UBC-GSRC/2026-w2-kuhn-fluxchamber/notes/inspiration.md

# Inspiration Procedure: 

- The Inspiration page is to house any materials that provide a good example of relevant implementations. This can be hyperlinks to articles, photos, etc. Almost like a Pinterest board.  

- Always use the date for each entry and tag your initials (YYYY-MM-DD AF)  

- Always put a new entry at the top of the page so you can see the newest work first  

- Do not use this as a default daily log. This page should describe updates at a higher level than the log.  

- Do not delete entries, this is meant to serve as a rudimentary version control and archive.  

- Leave the Procedure at the top of the page.
  
For Links 
[Duck Duck Go](https://duckduckgo.com)

For photos

 

or  



[image-ref]: https://www.markdownlang.com/image.jpg "Optional Title"        

or

Local Image
Parent Directory Image
Same Directory Image
Root Directory Image

# 2025-11-27 DF
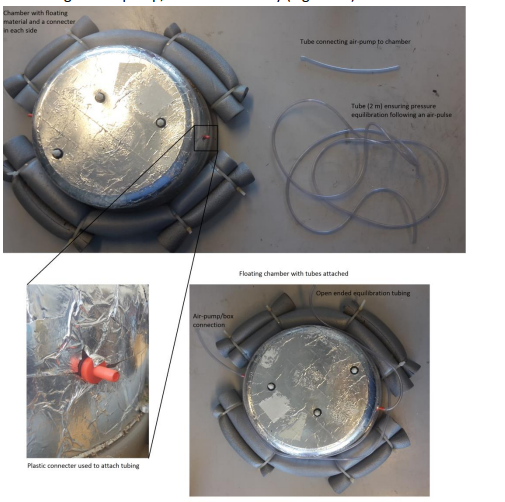
[picture p1: notes/images/co2_martinsen.png]
martinsen_co2flux

[martinsen_co2flux_suppliment](https://bg.copernicus.org/articles/15/5565/2018/bg-15-5565-2018-supplement.pdf)

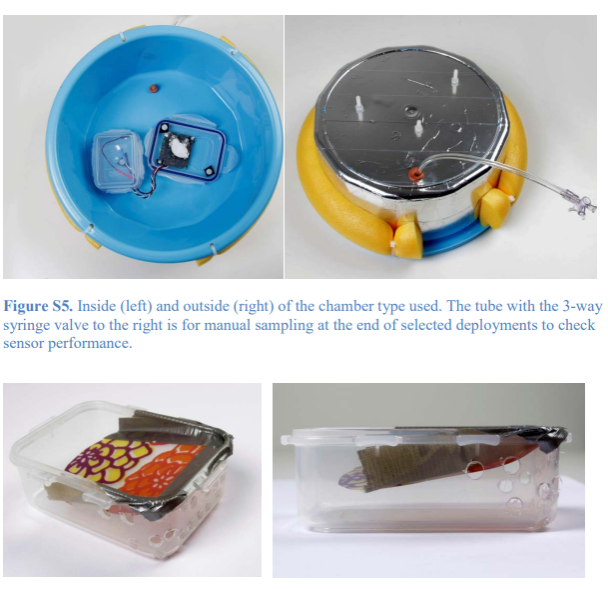
[picture p2: notes/images/bastvikken_co2flux.png]
bastvikken_co2flux

[bastvikken_co2flux_suppliment](https://bg.copernicus.org/articles/12/3849/2015/)

[woodwell_co2flux_context](https://www.woodwellclimate.org/zoe-dietrich-engineering-floating-methane-chamber/)
[woodwell_co2flux_suppliment](https://agupubs.onlinelibrary.wiley.com/action/downloadSupplement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)
