UBC-GSRC/2026-w2-kuhn-fluxchamber/firmware/supplemental/data_logger_uml_state_machine.drawio.png

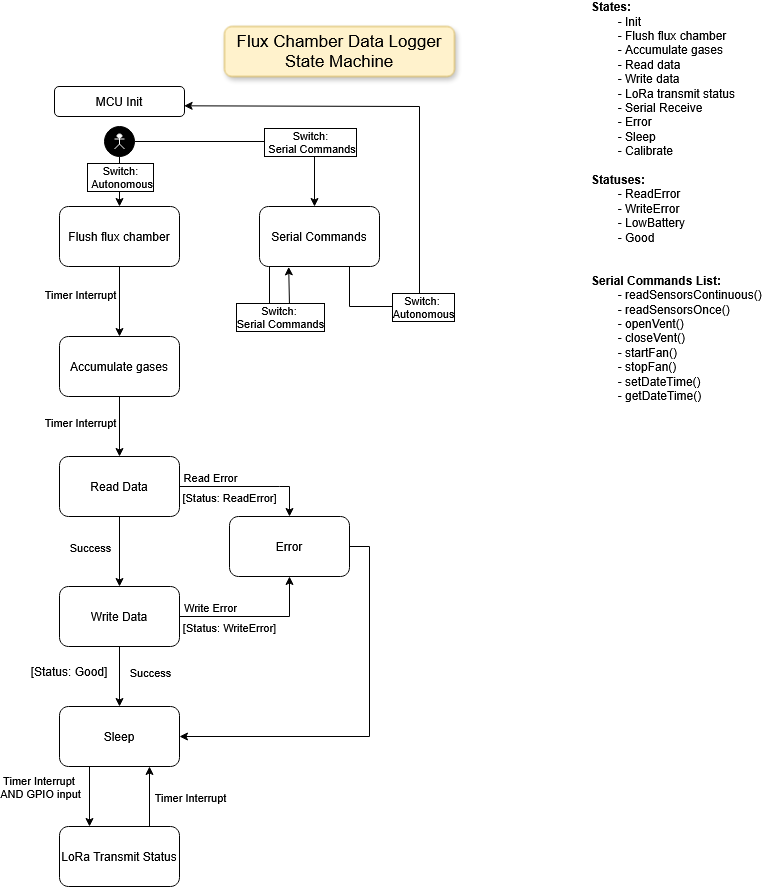
firmware/supplemental/data_logger_uml_state_machine.drawio.png
