UBC-GSRC/2026-w2-kuhn-fluxchamber/notes/key_components.md

# Key Components Procedure:  

- The Key Components page is to serve as a place to describe the details of key components. Think accuracy of sensors, load capacity of corner brackets, speed of motors, etc. If there is a 

- Always use the date for each entry and tag your initials (YYYY-MM-DD AF)  

- Always put a new entry at the top of the page so you can see the newest work first  

- Do not use this as a default daily log. This page should describe updates at a higher level than the log.  

- Do not delete entries, this is meant to serve as a rudimentary version control and archive.  

- Leave the Procedure at the top of the page.  

# 2025-11-27 

1ppm = 0.0001%
1% = 10000 ppm

| co2 | Measument Range | Accuracy | Repeatability | Datasheet |
| --- | --- | --- | --- | --- |
| SenseAir K33 ELG | 400ppm-5000ppm  | +/- 30ppm +/- 3% of measured value  | +/- 20ppm +/- 1% of measured value | (https://rmtplusstoragesenseair.blob.core.windows.net/docs/publicerat/PSP145.pdf)|
| Devin Fennerty | Devin.fennerty@ubc.ca  | Engineer | Name | Email |
| Adam Fong | Adam.fong@ubc.ca | Engineer | Name | Email |
| Name | Email | Role | Name | Email |
