UBC-GSRC/2026-w2-kuhn-fluxchamber/bill_of_materials/Bill Of Materials(Bill of Materials).csv

Bill of Materials
 |  |  |  |  |  | Total Pieces: | 53
 |  |  |  |  |  | Total Cost: | 1746.79
Final Part | Category | Name | Link | Quantity | Unit of Measurement | Per Unit Cost CAD | Shipping | True Cost | Has It been Ordered | How many ordered
Platform | Raw Materials | 24"x24"1/4" HDPE | https://www.grainger.ca/en/product/p/WWG1ZAY8?cm_mmc=PPC:+Google+PLA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 | 1 | Piece | $28.94 | $- | $28.94 | No
Platform | Raw Materials | 2" PVC Pipe | https://www.homedepot.ca/product/ipex-series-200-2-inch-x-10-feet-pvc-pipe-ips/1000667857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 | 3 | Piece 10 ft | $24.98 | $- | $74.94 | No
Platform | Raw Materials | 2" PVC T | https://www.grainger.ca/en/product/p/WWG22FL05?cm_mmc=PPC:+Google+PLA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 | 8 | Piece | $3.20 | $- | $25.60 | No
Platform | Raw Materials | 2" PVC Elbow | https://www.grainger.ca/en/product/p/WWG22FJ95?cm_mmc=PPC:+Google+PLA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 | 8 | Piece | $2.64 | $- | $21.12 | No
Platform | Raw Materials | Misc Bolts/Hardware | https://canadabolts.ca/products/metric-machine-screws-socket-head-cap-full-thread-stainless-steel-m6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 | 1 | Piece | $50.00 | $- | $50.00 | No
Electrical Box | Raw Materials | Din Rail | https://www.grainger.ca/en/product/p/GGE18Z760?cm_mmc=PPC:+Google+PLA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 | 1 | Piece | $6.85 | $- | $6.85 | Yes
Electrical Box | Raw Materials | Meija 24"x17"x12" case | https://www.amazon.ca/MEIJIA-Portable-Waterproof-Protection-Inserted/dp/B07ZBQTBRP?gad_source=1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 | 1 | Piece | $142.49 | $- | $142.49 | No
Electrical Box | Electrical Components | Battery 12V 50AH | https://www.amazon.ca/HumsiENK-Protection-Rechargeable-6000-15000-Lifetime/dp/B0FG7WVW8F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 | 1 | Piece | $149.99 | $- | $149.99 | No
Flux Chamber | Mechanical Components | Air Pump BD-02A-3L | https://bodenpumpstore.com/products/12v-eccentric-diaphragm-air-pump-bodenflo?variant=45735526138048 | 2 | Piece | $22.56 | $53.58 | $98.70 | Yes | 3 of them
Flux Chamber | Raw Materials | 10 Quart Bucket | https://www.uline.ca/BL_7028/Utility-Buckets?keywords=buckets | 1 | Piece | $19.00 | $- | $19.00 | No
Sensors | Raw Materials | 20"x20"x1" 20 PPI Foam | https://www.amazon.ca/ALEGI-Aquarium-Sponge-Filter-Sponges/dp/B0C99S8J7D?gad_source=1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 | 1 | Piece | $15.99 | $- | $15.99 | No
Sensors | Electrical Components | Figaro NGM 2611-E13 | https://www.figarosensor.com/product/entry/ngm2611.html | 7 | Piece | $33.74 | $60.00 | $296.18 | Yes
Sensors | Electrical Components | SenseAir K33 ELG | https://www.co2meter.com/en-ca/products/k-33-icb-co2-sensor?variant=19003982 | 1 | Piece | $400.00 | $- | $400.00 | No
Sensors | Electrical Components | SHT45 | https://www.mouser.ca/ProductDetail/Adafruit/5665?qs=mELouGlnn3dyBBHYyvKU4A%3D%3D | 1 | Piece | $20.00 |  | $20.00
Sensors | Raw Materials | 3D Filament PETG | https://3dprintingcanada.com/products/black-bambu-lab-petg-hf-filament-1-75mm-1-kg?variant=42508806684741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 | 1 | Spool | $29.99 | $- | $29.99
Data Logger | Electrical Components | QWIIC Breakout | https://www.mouser.ca/ProductDetail/485-5961 | 1 | Piece | $2.97 | $- | $2.97
Data Logger | Electrical Components | QWIIC Wire | https://www.mouser.ca/ProductDetail/485-4210 | 1 | Piece | $1.45 | $- | $1.45
Data Logger | Electrical Components | INA333 Amp | https://leeselectronic.com/en/product/18487-ina333-amplifier-op-amp-module-bio-micro-signal.html | 1 | Piece | $11.95 | $- | $11.95
Data Logger | Electrical Components | AD623 Amp | https://www.mouser.ca/ProductDetail/584-AD623ANZ | 1 | Piece | $14.84 | $- | $14.84
Data Logger | Electrical Components | RTC DS3231 Breakout Board | https://www.mouser.ca/ProductDetail/485-3013 | 1 | Piece | $26.64 | $- | $26.64
Data Logger | Electrical Components | External ADC I2C | https://www.mouser.ca/ProductDetail/Adafruit/5974?qs=IKkN%2F947nfAOkaWgHqoH5Q%3D%3D | 1 | Piece | $15.15 | $- | $15.15
Data Logger | Electrical Components | MISC Hardware | https://canadabolts.ca/products/metric-machine-screws-socket-head-cap-full-thread-stainless-steel-m2-5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 | 1 | Piece | $100.00 | $- | $100.00
Data Logger | Electrical Components | Solar Panel and charge controller | Eco-Worthy 25W 12V solar panel and controller ($60) | 1 | Piece | $60.00 | $- | $60.00
Data Logger | Electrical Components | Arduino MKR WAN | https://www.mouser.ca/ProductDetail/Arduino/ABX00029?qs=rkhjVJ6%2F3EJR8pfu7j970Q%3D%3D | 1 | Piece | $75.00 |  | $75.00
Data Logger | Electrical Components | DS3231 Breakout Board RTC | https://www.mouser.ca/ProductDetail/Adafruit/5188?qs=TCDPyi3sCW0TSTr1Xi7pUg%3D%3D | 1 | Piece | $22.00 |  | $22.00
Data Logger | Electrical Components | SanDisk Ultra 16GB | https://www.amazon.ca/SanDisk-Ultra-SDSQUNS-016G-GN3MN-UHS-I-microSDHC/dp/B074B4P7KD?s=electronics | 1 | Piece | $15.00 |  | $15.00
Data Logger | Electrical Components | L4931 5V Voltage Regulator | L4931 5V | 1 | Piece | $1.00 |  | $1.00
Data Logger | Electrical Components | L4931 3.3V Voltage Regulator | L4931 3.3V | 1 | Piece | $1.00 |  | $1.00
Data Logger | Electrical Components | MP1584 Buck Converter Breakout | MP1584 Buck Converter Breakout | 1 | Piece | $7.00 |  | $7.00
Data Logger | Electrical Components | 25W DC-DC Power Module | 25W DC-DC power module | 1 | Piece | $13.00 |  | $13.00
