UBC-GSRC/2026-w2-kuhn-fluxchamber/firmware/analysis/air_pump_rate_test_1.txt

This data came from a test in which two 12V air pumps were connected to the air chamber.
The air chamber did NOT have a water seal at the base so some CO2 was likely leaking from the poor
seal. But all of the wires at the top of the chamber were sealed using cable glands.

I took the first measurement, then exhaled into the chamber about 10 times. This saturated the sensor
to read 10,000 ppm. The rest is shown below.

NOTES:
- 2 air pumps, one pumping out one pumping in, simultaneously
- NO fan to circulate air

Date: 2025/12/22 Time: 13:42:50 CO2 (ppm): 581.0 Temp (C): 22.6 RH (%): 39.9
Date: 2025/12/22 Time: 13:43:21 CO2 (ppm): 835.0 Temp (C): 22.6 RH (%): 39.7
Date: 2025/12/22 Time: 13:43:52 CO2 (ppm): 10000.0 Temp (C): 23.1 RH (%): 99.9
Date: 2025/12/22 Time: 13:44:23 CO2 (ppm): 10000.0 Temp (C): 23.5 RH (%): 100.0
Date: 2025/12/22 Time: 13:44:54 CO2 (ppm): 10000.0 Temp (C): 23.2 RH (%): 100.0
Date: 2025/12/22 Time: 13:45:25 CO2 (ppm): 10000.0 Temp (C): 23.1 RH (%): 91.6
Date: 2025/12/22 Time: 13:45:56 CO2 (ppm): 10000.0 Temp (C): 23.1 RH (%): 88.5
Date: 2025/12/22 Time: 13:46:28 CO2 (ppm): 10000.0 Temp (C): 23.1 RH (%): 87.1
Date: 2025/12/22 Time: 13:46:59 CO2 (ppm): 9678.0 Temp (C): 23.0 RH (%): 86.3
Date: 2025/12/22 Time: 13:47:30 CO2 (ppm): 8155.0 Temp (C): 23.0 RH (%): 84.2
Date: 2025/12/22 Time: 13:48:01 CO2 (ppm): 6918.0 Temp (C): 22.9 RH (%): 82.7
Date: 2025/12/22 Time: 13:48:32 CO2 (ppm): 5880.0 Temp (C): 22.9 RH (%): 80.6
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
Date: 2025/12/22 Time: 14:04:37 CO2 (ppm): 515.0 Temp (C): 22.1 RH (%): 39.6
Date: 2025/12/22 Time: 14:05:09 CO2 (ppm): 516.0 Temp (C): 22.1 RH (%): 39.5
Date: 2025/12/22 Time: 14:05:40 CO2 (ppm): 511.0 Temp (C): 22.1 RH (%): 39.5
