UBC-GSRC/2026-w2-kuhn-fluxchamber/flux_measurements/flux_results.csv

start | end | n | dCdt_ppm_h | r2 | T_K | flux_umol_m2_h
2000-01-01 00:02:10 | 2000-01-01 00:11:59 | 20 | 583.701188455008 | 0.5923466164472444 | 298.25 | 4217.036079231312
2000-01-01 00:25:55 | 2000-01-01 00:35:44 | 20 | -59.54887218045173 | 0.3189687096252124 | 298.435 | -429.952993376065
2026-07-16 16:58:23 | 2026-07-16 17:08:12 | 20 | 101.3727868057231 | 0.9264781388520207 | 299.47499999999997 | 729.3869748710836
2026-07-16 18:58:26 | 2026-07-16 19:08:15 | 20 | 44.006791171475946 | 0.45430417146577173 | 299.64 | 316.45874793350947
2026-07-16 20:58:29 | 2026-07-16 21:08:18 | 20 | 48.02328401649263 | 0.8499387482158284 | 299.16499999999996 | 345.89020509823337
2026-07-16 22:58:32 | 2026-07-16 23:08:21 | 20 | 43.395585738538514 | 0.591656746198091 | 299.13 | 312.59553842191104
2026-07-17 00:58:34 | 2026-07-17 01:08:23 | 20 | 41.91122968712065 | 0.580539821403375 | 299.135 | 301.898089430233
2026-07-17 02:58:37 | 2026-07-17 03:08:26 | 20 | 38.59325733689059 | 0.5932561614051286 | 299.09 | 278.0396505644717
2026-07-17 04:58:40 | 2026-07-17 05:08:29 | 20 | 36.0611205432938 | 0.6377293307859382 | 298.955 | 259.9145474614893
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
