UBC-GSRC/2026-w2-kuhn-fluxchamber/power_measurements/complete_cycle_and_efficiency_dreams.csv

timestamp_local | current_mA | bus_V | shunt_mV | power_mW | energy_J | charge_C | temperature_C
2026-04-30T14:15:36 | -0.04 | 0 | 0 | 0 | 0 | 0 | 21.55
2026-04-30T14:15:37 | -0.02 | 0 | 0 | 0 | 0 | 0 | 21.54
2026-04-30T14:15:38 | -0.06 | 0 | 0 | 0 | 0 | 0 | 21.54
2026-04-30T14:15:39 | -0.13 | 0 | 0 | 0 | 0 | 0 | 21.54
2026-04-30T14:15:40 | -0.13 | 0 | 0 | 0 | 0 | 0 | 21.54
2026-04-30T14:15:41 | -0.04 | 0 | 0 | 0 | 0 | 0 | 21.53
2026-04-30T14:15:42 | -0.11 | 0 | 0 | 0 | 0 | 0 | 21.54
2026-04-30T14:15:43 | 0.06 | 0 | 0 | 0 | 0 | 0 | 21.55
2026-04-30T14:15:44 | -0.23 | 0 | 0 | 0 | 0 | 0 | 21.55
2026-04-30T14:15:45 | -0.02 | 0 | 0 | 0 | 0 | 0 | 21.56
2026-04-30T14:15:46 | 0.02 | 0 | 0 | 0 | 0 | 0 | 21.57 |  |  | Buck Converter Powering |  |  |  |  | Linear Regulator Powering
2026-04-30T14:15:47 | -0.11 | 0 | 0 | 0 | 0 | 0 | 21.57
2026-04-30T14:15:48 | -0.08 | 0 | 0 | 0 | 0 | 0 | 21.57 |  |  |  | State | Time (s) | Current Avg (mA) | Average mW |  | State | Time (s) | Current Avg (mA) | Average mW
2026-04-30T14:15:49 | 92.37 | 12.2 | 1.39 | 1127.26 | 0.77 | 0.07 | 21.57 | 1 | 257.1894355 | Opening | 1 | 10 | 1144.928 | 11449.28 | Opening | 1 | 10 | 3434.784 | 34347.84
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
