UBC-GSRC/2026-w2-kuhn-fluxchamber/flux_measurements/data/datalog.csv

date | time | co2 | temp | rh | V_ch4 | type | V_batt
2000/01/01 | 00:01:37 | 606.0 | 23.8 | 65.7 | 0.336 | 0
2000/01/01 | 00:02:10 | 593.0 | 24.0 | 65.0 | 0.355 | 1
2000/01/01 | 00:02:41 | 562.0 | 24.2 | 64.2 | 0.369 | 1
2000/01/01 | 00:03:12 | 562.0 | 24.4 | 63.6 | 0.381 | 1
2000/01/01 | 00:03:43 | 571.0 | 24.5 | 63.0 | 0.388 | 1
2000/01/01 | 00:04:14 | 561.0 | 24.6 | 62.5 | 0.393 | 1
2000/01/01 | 00:04:45 | 569.0 | 24.8 | 62.1 | 0.395 | 1
2000/01/01 | 00:05:16 | 562.0 | 24.9 | 61.8 | 0.396 | 1
2000/01/01 | 00:05:47 | 581.0 | 25.0 | 61.4 | 0.397 | 1
2000/01/01 | 00:06:18 | 611.0 | 25.1 | 61.0 | 0.398 | 1
2000/01/01 | 00:06:49 | 647.0 | 25.2 | 60.7 | 0.399 | 1
2000/01/01 | 00:07:20 | 602.0 | 25.3 | 60.3 | 0.399 | 1
2000/01/01 | 00:07:51 | 587.0 | 25.3 | 60.1 | 0.399 | 1
2000/01/01 | 00:08:22 | 665.0 | 25.4 | 61.3 | 0.398 | 1
2000/01/01 | 00:08:53 | 610.0 | 25.4 | 59.8 | 0.396 | 1
2000/01/01 | 00:09:24 | 645.0 | 25.5 | 59.6 | 0.396 | 1
2000/01/01 | 00:09:55 | 612.0 | 25.6 | 59.4 | 0.395 | 1
2000/01/01 | 00:10:26 | 620.0 | 25.6 | 59.3 | 0.392 | 1
2000/01/01 | 00:10:57 | 605.0 | 25.7 | 59.1 | 0.394 | 1
2000/01/01 | 00:11:28 | 674.0 | 25.7 | 59.4 | 0.395 | 1
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
