UBC-GSRC/2026-w2-kuhn-fluxchamber/kicad/data_logger/data_logger.kicad_pcb

## KiCad design kicad/data_logger/data_logger.kicad_pcb (2026-04-23)

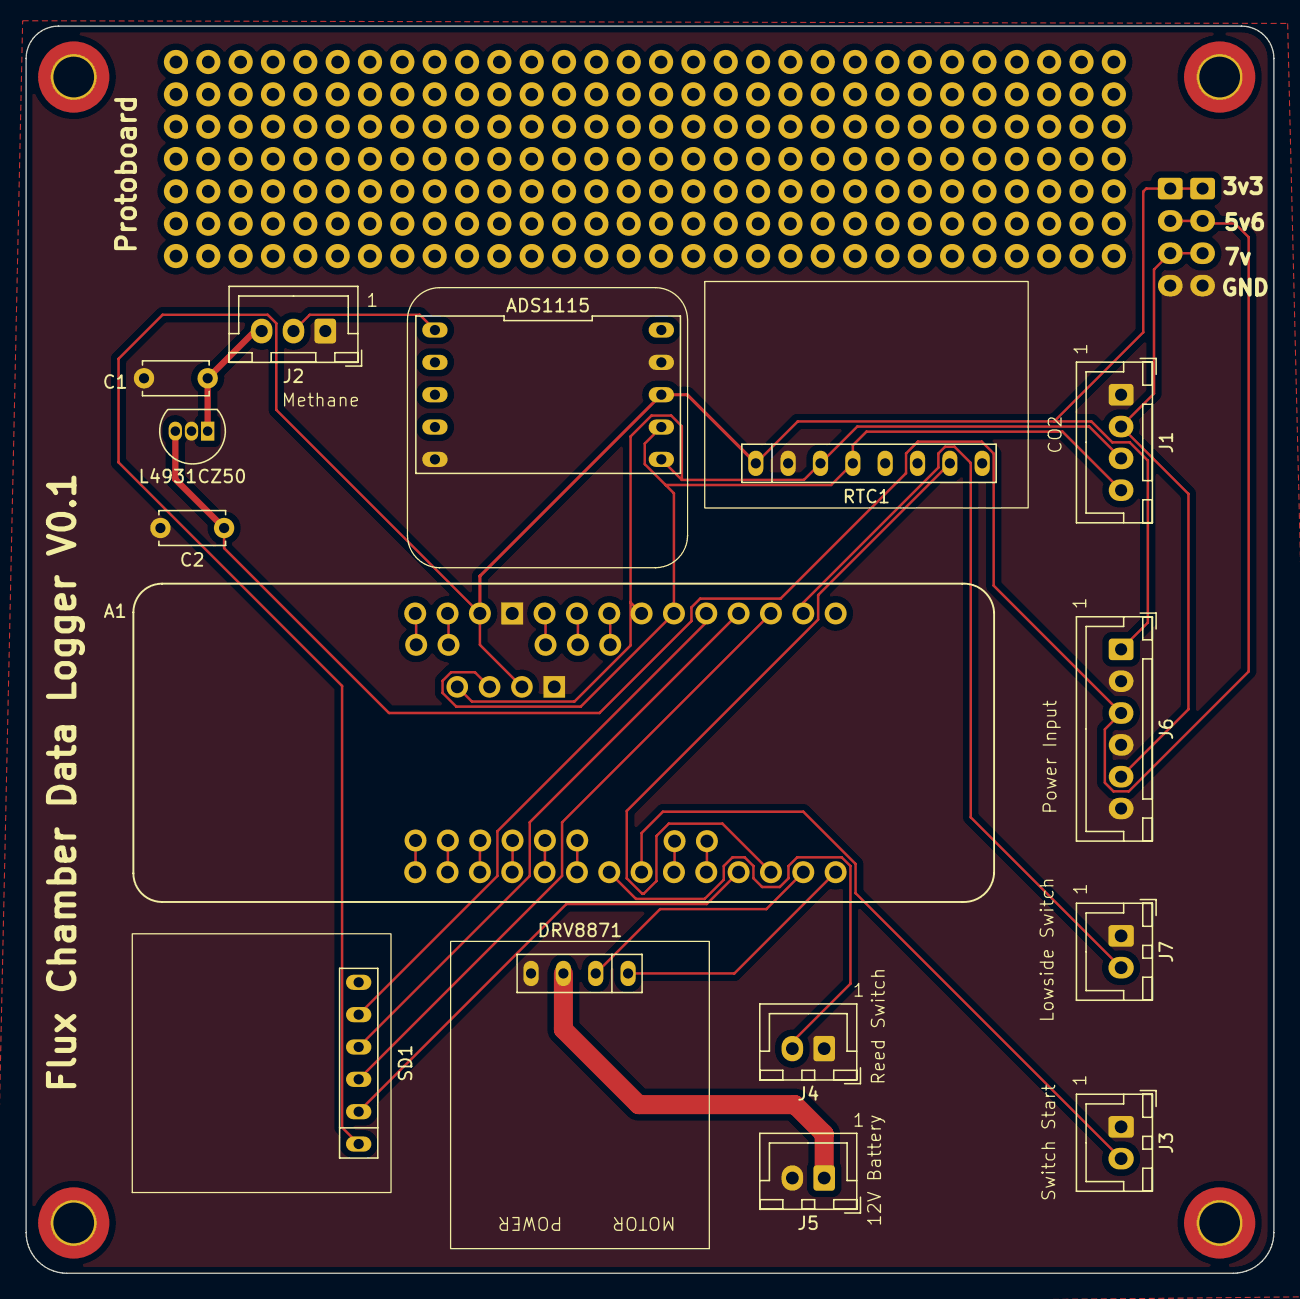
[picture p5: board data_logger.kicad_pcb from above]

Board: 2 copper layers, 98.0 x 98.0 mm, 15 parts (0 on the bottom side), 19 nets.

Parts:
A1: Arduino_MKR_WAN_1310_Socket; Arduino_MKR_FOX_1200_Socket
ADS1115: ADS1115_breakout_soldered
C1, C2: 2.2uF; C_Disc_D5.0mm_W2.5mm_P5.00mm
DRV8871: DRV8871
J1: Conn_01x04_Pin; JST_XH_B4B-XH-A_1x04_P2.50mm_Vertical
J2: Conn_01x03_Pin; JST_XH_B3B-XH-A_1x03_P2.50mm_Vertical
J3, J4, J5, J7: Conn_01x02_Pin; JST_XH_B2B-XH-A_1x02_P2.50mm_Vertical
J6: Conn_01x06_Pin; JST_XH_B6B-XH-A_1x06_P2.50mm_Vertical
L4931CZ50: TO-92L_Inline
RTC1: RTC_DS3231_breakout
SD1: SD Breakout Board; SD_Breakout_offbrand

Connections:
+5V: C1.1, J2.3, L4931CZ50.1 (V_OUT)
/3V3: A1.3V3 (3.3V), ADS1115.8 (VCC), J6.1, RTC1.1 (Vin), SD1.1 (3V3)
/5V6: C2.1, J6.3, L4931CZ50.3 (V_IN)
/6to9V: J1.2, J6.5
/D2: A1.D2, SD1.2 (CS)
/D3: A1.D3, RTC1.7 (SQW)
/D7: A1.D7, J7.2
/MISO: A1.D10 (D10_MISO), SD1.5 (MISO/POCI)
/MOSI: A1.D8 (D8_MOSI), SD1.3 (MOSI/PICO)
/PWM_forward: A1.D4, DRV8871.2 (IN1)
/PWM_reverse: A1.D5, DRV8871.1 (IN2)
/SCK: A1.D9 (D9_SCK), SD1.4 (CLK)
/SCL: A1.D12 (D12/SCL), ADS1115.6 (SCL), J1.3, RTC1.3 (SCL)
/SDA: A1.D11 (D11/SDA), ADS1115.7 (SDA), J1.4, RTC1.4 (SDA)
/SW_Start: A1.A6, J3.2
/SW_manual: A1.A5, J4.2
/V_bat: DRV8871.3 (VM), J5.1
/methane_out: ADS1115.1 (A0), J2.2
GND1: A1.GND, ADS1115.5 (GND), ADS1115.9 (GND), C1.2, C2.2, DRV8871.4 (GND), J1.1, J2.1, J3.1, J4.1, J5.2, J6.2, J6.4, J6.6, J7.1, L4931CZ50.2 (GND), RTC1.2 (GND)
