UBC-GSRC/2026-w2-kuhn-fluxchamber/kicad/logger_hat/logger_hat/logger_hat.kicad_pcb

## KiCad design kicad/logger_hat/logger_hat/logger_hat.kicad_pcb (2026-02-07)

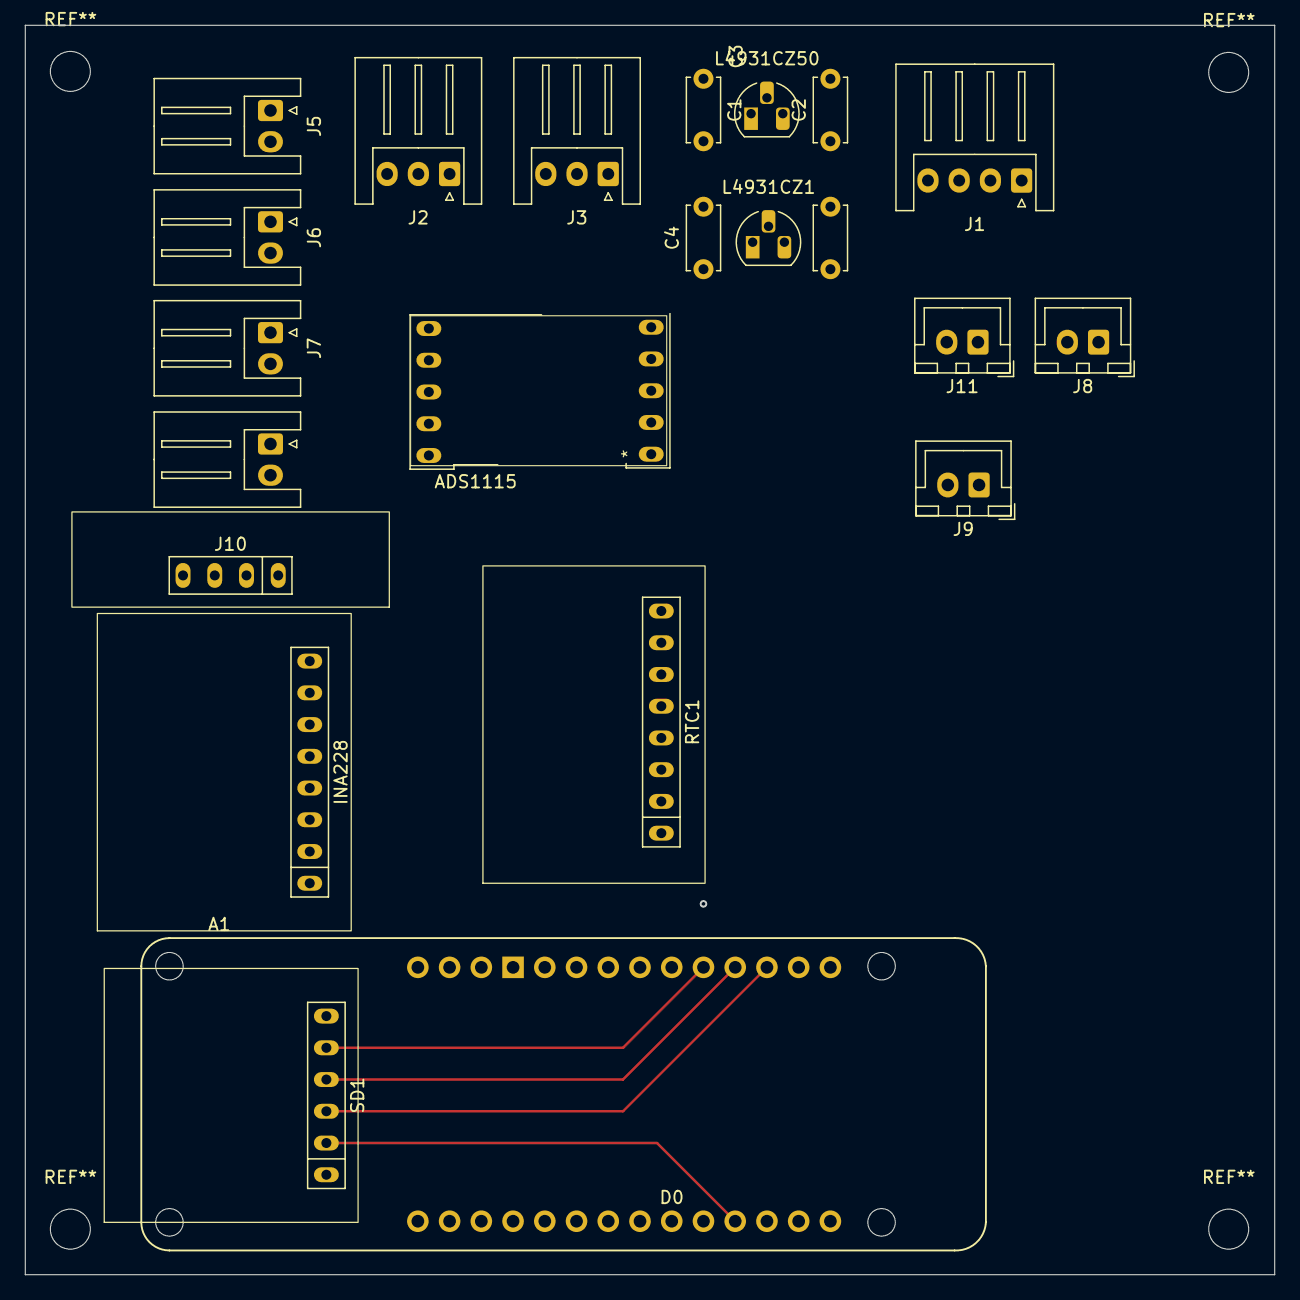
[picture p6: board logger_hat.kicad_pcb from above]

Board: 2 copper layers, 100.0 x 100.0 mm, 22 parts (0 on the bottom side), 20 nets.

Parts:
A1: Arduino_MKR_WAN_1310_Socket; Arduino_MKR_FOX_1200_Socket
ADS1115: ADC_16-bit_ADS1115_breakout
C1, C4: 2.2uF; C_Disc_D5.0mm_W2.5mm_P5.00mm
C2, C3: 0.1uF; C_Disc_D5.0mm_W2.5mm_P5.00mm
INA228: INA228_adafruit_module
J1: CO2_sensor_conn; JST_XH_S4B-XH-A_1x04_P2.50mm_Horizontal
J2: 3V3_sensor_conn; JST_XH_S3B-XH-A_1x03_P2.50mm_Horizontal
J3: CH4_Sensor_conn; JST_XH_S3B-XH-A_1x03_P2.50mm_Horizontal
J4: SW_RD; JST_XH_S2B-XH-A_1x02_P2.50mm_Horizontal
J5: PWM_output_1; JST_XH_S2B-XH-A_1x02_P2.50mm_Horizontal
J6: SW_LOG; JST_XH_S2B-XH-A_1x02_P2.50mm_Horizontal
J7: PWM_output_2; JST_XH_S2B-XH-A_1x02_P2.50mm_Horizontal
J8: 7V_IN; JST_XH_B2B-XH-A_1x02_P2.50mm_Vertical
J9: 3V3_IN; JST_XH_B2B-XH-A_1x02_P2.50mm_Vertical
J10: Conn_01x04_Pin; SparkFun_Stemma_Adapter
J11: 5V6_IN; JST_XH_B2B-XH-A_1x02_P2.50mm_Vertical
L4931CZ1, L4931CZ50: TO-92_HandSolder
RTC1: RTC_DS3231_breakout
SD1: SD Breakout Board; SD_Breakout_offbrand

Connections:
+3V3: C4.1, J2.1, L4931CZ1.1 (V_OUT)
+5V: C1.1, J3.1, L4931CZ50.1 (V_OUT)
/3V3: A1.3V3 (3.3V), ADS1115.8 (VCC), INA228.1 (VIN), J9.1, J10.2, RTC1.1 (Vin), SD1.1 (3V3)
/5V6: C2.1, C3.1, J11.1, L4931CZ1.3 (V_IN), L4931CZ50.3 (V_IN)
/6to9V: J1.2, J8.1
/D2: A1.D2, SD1.2 (CS)
/D3: A1.D3, RTC1.7 (SQW)
/D4: A1.D4, J6.1
/D5: A1.D5, J4.1
/D7: A1.D7, J7.1
/MISO: A1.D10 (D10_MISO), SD1.5 (MISO/POCI)
/MOSI: A1.D8 (D8_MOSI), SD1.3 (MOSI/PICO)
/PWM: A1.D1, J5.1
/SCK: A1.D9 (D9_SCK), SD1.4 (CLK)
/SCL: A1.D12 (D12/SCL), ADS1115.6 (SCL), INA228.3 (SCL), J1.4, J10.4, RTC1.3 (SCL)
/SDA: A1.D11 (D11/SDA), ADS1115.7 (SDA), INA228.4 (SDA), J1.3, J10.3, RTC1.4 (SDA)
/V_bat: INA228.5 (VBUS), INA228.7 (VIN+)
/methane_out: ADS1115.1 (A0), J3.2
/sensor_out: ADS1115.2 (A1), J2.2
GND: A1.GND, ADS1115.5 (GND), ADS1115.9 (GND), C1.2, C2.2, C3.2, C4.2, INA228.2 (GND), J1.1, J2.3, J3.3, J4.2, J5.2, J6.2, J7.2, J8.2, J9.2, J10.1, J11.2, L4931CZ1.2 (GND), L4931CZ50.2 (GND), RTC1.2 (GND), SD1.6 (GND)
