UBC-GSRC/2026-w2-kuhn-fluxchamber/firmware/src/main.cpp

#include <Arduino.h>
#include <SPI.h>
#include <SD.h>
#include "utils.h"
#include <Co2Meter_K33.h>
#include "ArduinoLowPower.h"
#include "SerialCommands.h"
#include <LoRa.h>
#include "INA226.h"

#define TYPE_CALIBRATION 0
#define TYPE_MEASUREMENT 1
#define TYPE_UNDER_VOLTAGE 2
#define MINIMUM_VOLTAGE 12.25

enum State {
  INIT,             // Initialize the system
  FLUSH_CHAMBER,    // Fill chamber with fresh air
  ACCUMULATE_AND_READ, // Accumulate gas and read data from sensors
  ACCUMULATE_GAS,   // Let gas accumulate in chamber before measurement
  READ_DATA,        // Read data from sensor(s)
  LOG_DATA,         // Log data to SD card
  SLEEP,            // Enter low-power sleep mode
  FAKE_SLEEP,       // Fake sleep for testing
  // LORA_RECEIVE,     // Listen for serial commands
  SLEEP_AND_TRANSMIT, // Sleep and transmit data over LoRa
  LORA_TRANSMIT,    // Transmit status over communication module
  SERIAL_COMMANDS,   // Listen for serial commands
  BLINK,            // Blink LED for testing
  CALIBRATE,        // Calibrate sensors
  TEST_BLINK_DELAY, // Test blinking with delay (blocking)
  TEST_BLINK_MILLIS, // Test blinking with millis (non-blocking)
  ERROR             // Handle errors
};

INA226 INA(0x40);
Co2Meter_K33 k33;
MethaneSensor methaneSensor(0);
State state = INIT;
// State state = FLUSH_CHAMBER;
// State state = SERIAL_COMMANDS;
State statePrev;

const char* datalogFile = "datalog.csv";
unsigned long stateStartMillis = 0;
unsigned long initStartUnixTime_s;
unsigned long accumulateStartUnixTime_s;
const unsigned long VENT_OPEN_DURATION = 5 * 1000; // Duration to open vent in milliseconds
const unsigned long VENT_CLOSE_DURATION = VENT_OPEN_DURATION + 1000; // Close for longer than open to ensure vent is fully closed
const unsigned long FAN_ON_DURATION = 30 * 1000;
const unsigned long CALIBRATE_DURATION = 60 * 1000; // milliseconds
const unsigned long FLUSH_DURATION = VENT_OPEN_DURATION + VENT_CLOSE_DURATION + FAN_ON_DURATION + CALIBRATE_DURATION; //  milliseconds
const unsigned long ACCUMULATE_DURATION = 3 * 1000; // milliseconds
const unsigned long MEASUREMENT_INTERVAL = 30 * 1000; // time between readings in milliseconds
const unsigned long MEASUREMENT_WINDOW = 10 * 60 * 1000; // time window in which we take periodic measurements in milliseconds 
const unsigned long MEASUREMENT_COUNT = (MEASUREMENT_WINDOW + 1000) / MEASUREMENT_INTERVAL; // number of measurements to take in the measurement window (adding a second to make sure integer division doesn't round down)
const unsigned long SAMPLE_INTERVAL = 1 * 60 * 60 * 1000; // milliseconds
const unsigned long CO2_GAS_DIFFUSION_DURATION = 25 * 1000; //  milliseconds
const unsigned long FAKE_SLEEP_DURATION = 15 * 1000; //  milliseconds for testing
const unsigned long LORA_TRANSMIT_INTERVAL = 10 * 60 * 1000; // milliseconds
const unsigned long SLEEP_AND_TRANSMIT_DURATION = SAMPLE_INTERVAL - FLUSH_DURATION - CO2_GAS_DIFFUSION_DURATION - MEASUREMENT_WINDOW; // milliseconds
const unsigned long LORA_TRANSMISSIONS_COUNT = SLEEP_AND_TRANSMIT_DURATION / LORA_TRANSMIT_INTERVAL; // number of lora transmissions during sleep and transmit state
const unsigned long LORA_TRANSMIT_DURATION = 300; // milliseconds
const unsigned long FINAL_SLEEP_DURATION = SLEEP_AND_TRANSMIT_DURATION - ((LORA_TRANSMISSIONS_COUNT * LORA_TRANSMIT_INTERVAL) + (LORA_TRANSMISSIONS_COUNT * LORA_TRANSMIT_DURATION)); // milliseconds
// const unsigned long SAMPLE_INTERVAL = 3 * 60 * 60 * 1000; // milliseconds (eventually should be between 1 and 3 hours, lowest you can reasonably do with your battery)
SensorData data;

unsigned PIN_WAKEUP = 3; // Pin to wake up from sleep
unsigned PIN_FAN = 7; // Pin to control fan
#define PIN_SWITCH A6 // Change to A6
#define PIN_REED_SWITCH A5 // Change to A5
unsigned PIN_MOTOR_FORWARD_PWM = 5;
unsigned PIN_MOTOR_REVERSE_PWM = 4;
unsigned localAddress = 0xBB; // LoRa local address
unsigned destinationAddress = 0xFF; // LoRa destination address
bool flagReadContinuous = false; // Flag to indicate continuous reading mode
bool flagTransmitLora = false;

void ledStateIndicator(int numBlinks) {
  for (int i = 0; i < numBlinks; i++) {
    digitalWrite(LED_BUILTIN, HIGH);
    delay(200);
    digitalWrite(LED_BUILTIN, LOW);
    delay(200);
  }
}

void LoRaTransmitSingle(bool calibration = false){
  if (!LoRa.begin(915E6)) {
      while (1){
        digitalWrite(LED_BUILTIN, HIGH);
        delay(100);
        digitalWrite(LED_BUILTIN, LOW);
        delay(100);
      }
    }

    char t[16];
    rtc_get_time(2, t, sizeof(t));
    LoRa.beginPacket();
    LoRa.write(destinationAddress);
    LoRa.write(localAddress);
    LoRa.print("Date: "); LoRa.print(data.date);
    LoRa.print(" Time: "); LoRa.print(data.time);
    LoRa.print(" Temp: "); LoRa.print(data.temp);
    LoRa.print(" RH: "); LoRa.print(data.rh);
    LoRa.print(" CO2: "); LoRa.print(data.co2);
    LoRa.print(" CH4: "); LoRa.print(data.ch4);
    LoRa.print(" V: "); LoRa.print(data.voltage);
    if (calibration){
      LoRa.print(" Type: Calibration");
    } else {
      LoRa.print(" Type: Measurement");
    }
    
    LoRa.endPacket();

    LoRa.end();
}
void wakeupCallback() {
  // This function will be called once on device wakeup
  state = LORA_TRANSMIT;
}

void rtcAlarmCallback(){
  flagTransmitLora = true;
}

void turnOnFan(int duration_ms) {
  digitalWrite(PIN_FAN, HIGH);
  delay(duration_ms);
  digitalWrite(PIN_FAN, LOW);
}

void reedSwitchCallback(){
  // Change this to start a full read sequence instead of just blinking
  state = BLINK;
}

void openVent(){
  digitalWrite(PIN_MOTOR_REVERSE_PWM, LOW); // Ensure reverse is off

  digitalWrite(PIN_MOTOR_FORWARD_PWM, HIGH); // Full speed forward
  delay(VENT_OPEN_DURATION); // Run motor for specified duration
  digitalWrite(PIN_MOTOR_FORWARD_PWM, LOW ); // Stop motor
}

void closeVent(){
  digitalWrite(PIN_MOTOR_FORWARD_PWM, LOW); // Ensure forward is off

  digitalWrite(PIN_MOTOR_REVERSE_PWM, HIGH); // Full speed reverse
  delay(VENT_CLOSE_DURATION); // Run motor for specified duration
  digitalWrite(PIN_MOTOR_REVERSE_PWM, LOW); // Stop motor
}

void readDataBlocking(bool calibration = false){
  k33.initPoll();
  delay(CO2_GAS_DIFFUSION_DURATION);

  // wait until CO2 sensor is ready, then read data        
  rtc_get_time(1, data.date, sizeof(data.date));
  rtc_get_time(2, data.time, sizeof(data.time));
  snprintf(data.temp, sizeof(data.temp), "%.1f", k33.readTemp());
  delay(20);
  snprintf(data.rh, sizeof(data.rh), "%.1f", k33.readRh());
  delay(20);
  snprintf(data.co2, sizeof(data.co2), "%.1f", k33.readCo2());
  delay(20);
  snprintf(data.ch4, sizeof(data.ch4), "%.3f", methaneSensor.readVoltage());
  delay(20);
  snprintf(data.voltage, sizeof(data.voltage), "%.3f", INA.getBusVoltage());
  delay(20);

  if (calibration){
    snprintf(data.type, sizeof(data.type), "%d", TYPE_CALIBRATION);
  } else {
    snprintf(data.type, sizeof(data.type), "%d", TYPE_MEASUREMENT);
  }
  
  if (Serial) {
    Serial.print("Date: "); Serial.print(data.date);
    Serial.print(" Time: "); Serial.print(data.time);
    Serial.print(" CO2 (ppm): "); Serial.print(data.co2);
    Serial.print(" Temp (C): "); Serial.print(data.temp);
    Serial.print(" RH (%): "); Serial.print(data.rh);
    Serial.print(" CH4 (V): "); Serial.println(data.ch4);
    Serial.print(" Type: "); Serial.println(data.type);
    Serial.print(" Voltage: "); Serial.println(data.voltage);
  }
}

void setup() {
    Serial.begin(9600);
    Serial.println("SD Initializing...");
    if (!SD.begin(chipSelectSD)) {
    }

    // Create file if missing
    if (!SD.exists(datalogFile)) {
        File file = SD.open(datalogFile, FILE_WRITE);
        if (file) {
            Serial.print("Created file: ");
            Serial.println(datalogFile);
            file.close();
        } else {
            Serial.print("Failed to create file: ");
            Serial.println(datalogFile);
        }
    }

    Serial.println("SD initialization done.");
    rtc_init(false); // false = do not set time
    Wire.begin();
    methaneSensor.begin();
    INA.begin();
    INA.setMaxCurrentShunt(1, 0.002);

    pinMode(PIN_WAKEUP, INPUT_PULLUP);
    pinMode(PIN_FAN, OUTPUT);
    pinMode(PIN_SWITCH, INPUT_PULLUP);
    pinMode(PIN_REED_SWITCH, INPUT_PULLUP);
    pinMode(PIN_MOTOR_FORWARD_PWM, OUTPUT);
    pinMode(PIN_MOTOR_REVERSE_PWM, OUTPUT);

    LowPower.attachInterruptWakeup(PIN_WAKEUP, wakeupCallback, CHANGE);
    LowPower.attachInterruptWakeup(PIN_REED_SWITCH, reedSwitchCallback, FALLING);
    // attachInterrupt(digitalPinToInterrupt(PIN_REED_SWITCH), reedSwitchCallback, FALLING);
}

void loop() {
  switch (state) {

    case INIT:{
      // Initialization 
      if (Serial){
          Serial.println("INIT");
        }
        
      if (digitalRead(PIN_SWITCH) == LOW){
        state = SERIAL_COMMANDS; // Go to serial commands if switch is low 
      } else {
        state = FLUSH_CHAMBER; // Start in normal mode if switch is high
      }
      break;
    }
    
    case FLUSH_CHAMBER:{
      // Flush the chamber to reach equilibrium with ambient air.
      // 1. Open vent 
      // 2. Turn on fan for set duration
      // 3. Close vent
      if (stateStartMillis == 0) {
        if (Serial){
          Serial.println("FLUSH_CHAMBER");
        }
        // Safety to prevent discharging past minimum safe voltage. Waits to get more charge from solar
        // Sleep for a long time!
        while (INA.isConnected() & INA.getBusVoltage() < MINIMUM_VOLTAGE){ 
          rtc_get_time(1, data.date, sizeof(data.date));
          rtc_get_time(2, data.time, sizeof(data.time));
          snprintf(data.temp, sizeof(data.temp), "%.1f", 0);
          delay(20);
          snprintf(data.rh, sizeof(data.rh), "%.1f", 0);
          delay(20);
          snprintf(data.co2, sizeof(data.co2), "%.1f", 0);
          delay(20);
          snprintf(data.ch4, sizeof(data.ch4), "%.3f", 0);
          delay(20);
          snprintf(data.type, sizeof(data.type), "%d", TYPE_UNDER_VOLTAGE);
          delay(20);
          snprintf(data.voltage, sizeof(data.voltage), "%.3f", INA.getBusVoltage());
          delay(20);
          
          log_data(data, datalogFile); 
          LowPower.sleep(1 * 60 * 60 * 1000);
        }

        stateStartMillis = millis();
        initStartUnixTime_s = rtc.now().unixtime();
        // open vent 
        openVent();
        digitalWrite(PIN_FAN, HIGH);
        delay(FAN_ON_DURATION);
        // Sleep a bit before starting sensor reading procedure
        digitalWrite(PIN_FAN, LOW);
        delay(CALIBRATE_DURATION - CO2_GAS_DIFFUSION_DURATION); // Wait for calibration duration
        readDataBlocking(true); // Read data after calibration duration
        log_data(data, datalogFile); // Log data after calibration duration
        LoRaTransmitSingle(true); // Transmit data after calibration duration
        closeVent();
        state = ACCUMULATE_AND_READ;
        stateStartMillis = 0;
      }
      break;
    }

    case ACCUMULATE_AND_READ: {
      // Let gas accumulate in chamber through diffusive flux and read data from sensors periodically
      unsigned long elapsedTime = rtc.now().unixtime() - accumulateStartUnixTime_s;
      if (stateStartMillis == 0) {
        if (Serial){
          Serial.println("ACCUMULATE_AND_READ");
        }
        stateStartMillis = millis();
      }
      // else if (elapsedTime >= (MEASUREMENT_WINDOW / 1000)) { // Accumulate and read for a set duration
      //   state = SLEEP_AND_TRANSMIT; // Move to SLEEP_AND_TRANSMIT state after the accumulation and reading duration
      //   stateStartMillis = 0;
      // }
      else if (MEASUREMENT_COUNT > 0) { // Read data at set intervals
        // send message to CO2 sensor to start reading data
        for (int i = 0; i < MEASUREMENT_COUNT; i++) {
          k33.initPoll();
          
          // Sleep for the duration of CO2 gas diffusion
          LowPower.sleep(CO2_GAS_DIFFUSION_DURATION); 
          
          // get data
          unsigned long procTime = millis();
          rtc_get_time(1, data.date, sizeof(data.date));
          rtc_get_time(2, data.time, sizeof(data.time));
          snprintf(data.temp, sizeof(data.temp), "%.1f", k33.readTemp());
          delay(20);
          snprintf(data.rh, sizeof(data.rh), "%.1f", k33.readRh());
          delay(20);
          snprintf(data.co2, sizeof(data.co2), "%.1f", k33.readCo2());
          delay(20);
          snprintf(data.ch4, sizeof(data.ch4), "%.3f", methaneSensor.readVoltage());
          delay(20);
          snprintf(data.type, sizeof(data.type), "%d", TYPE_MEASUREMENT);
          delay(20);
          snprintf(data.voltage, sizeof(data.voltage), "%.3f", INA.getBusVoltage());
          delay(20);
          
          // write to SD
          log_data(data, datalogFile); 
          
          // send LoRa transmission
          LoRaTransmitSingle(false);
          unsigned long totalProcTime = millis() - procTime;
          
          // sleep until the next measurement interval
          LowPower.sleep(MEASUREMENT_INTERVAL - CO2_GAS_DIFFUSION_DURATION - totalProcTime); // Sleep for the remaining time in the measurement interval. Subtract 300 ms to not overshoot
        }
        state = SLEEP_AND_TRANSMIT; // Move to SLEEP_AND_TRANSMIT state after the accumulation and reading duration
        stateStartMillis = 0;
      }
      break;
    }

    case ACCUMULATE_GAS:{
      // Let gas accumulate in chamber through diffusive flux 
      // 1. Wait for set duration (sleep?) 
      if (stateStartMillis == 0) {
        if (Serial){
          Serial.println("ACCUMULATE_GAS");
        }
        stateStartMillis = millis();
      }
      else if (millis() - stateStartMillis >= ACCUMULATE_DURATION) { // Accumulate for 10 seconds
        state = READ_DATA;
        stateStartMillis = 0;
      }
      break;
    }

    case READ_DATA: {
      // Read data from sensors 
      // 1. Read timestamp from RTC, temperature, humidity, CO2 and methane voltage from sensors
      if (stateStartMillis == 0) {
        if (Serial){
          Serial.println("READ_DATA");
        }
        stateStartMillis = millis();
        k33.initPoll();
      }
      else if (millis() - stateStartMillis >= CO2_GAS_DIFFUSION_DURATION) { // Warmup
        // wait until CO2 sensor is ready, then read data        
        // progress in the state machine
        rtc_get_time(1, data.date, sizeof(data.date));
        rtc_get_time(2, data.time, sizeof(data.time));
        snprintf(data.temp, sizeof(data.temp), "%.1f", k33.readTemp());
        delay(20);
        snprintf(data.rh, sizeof(data.rh), "%.1f", k33.readRh());
        delay(20);
        snprintf(data.co2, sizeof(data.co2), "%.1f", k33.readCo2());
        delay(20);
        snprintf(data.ch4, sizeof(data.ch4), "%.3f", methaneSensor.readVoltage());
        delay(20);
        snprintf(data.voltage, sizeof(data.voltage), "%.3f", INA.getBusVoltage());
        delay(20);
          
        stateStartMillis = 0;
        
        if (Serial) {
          Serial.print("Date: "); Serial.print(data.date);
          Serial.print(" Time: "); Serial.print(data.time);
          Serial.print(" CO2 (ppm): "); Serial.print(data.co2);
          Serial.print(" Temp (C): "); Serial.print(data.temp);
          Serial.print(" RH (%): "); Serial.print(data.rh);
          Serial.print(" CH4 (V): "); Serial.print(data.ch4);
        }
        state = LOG_DATA;
      }
      else {
        digitalWrite(LED_BUILTIN, HIGH); // Turn on LED while waiting for sensor to be ready
        delay(1000);
        digitalWrite(LED_BUILTIN, LOW); // Turn off LED after reading data
        delay(1000);
      }
      break;
    }

    case LOG_DATA: {
      // Log data to SD card
      if (Serial){
          Serial.println("LOG_DATA");
      }

      log_data(data, datalogFile); 
      state = LORA_TRANSMIT;
      break;
    }

    case SLEEP_AND_TRANSMIT:{
        if (LORA_TRANSMISSIONS_COUNT > 0) {
          for (unsigned long i = 0; i < LORA_TRANSMISSIONS_COUNT; i++) {
            LowPower.sleep(LORA_TRANSMIT_INTERVAL); // Sleep for the duration of the LORA transmit interval before transmitting
            LoRaTransmitSingle();
          }
        }
        LowPower.sleep(FINAL_SLEEP_DURATION); // Sleep for the final duration before restarting the cycle
        state = FLUSH_CHAMBER; // Restart the cycle
        break;
    }

    case LORA_TRANSMIT:{
      // Transmit information over LORA
      if (Serial){
        Serial.println("LORA_TRANSMIT");
      } 

      LoRaTransmitSingle();

      state = SLEEP;
      break;
    }

    // case LORA_RECEIVE:{
    //   // Listen for incoming LORA packets which match a known format
    //   // Listen for a set duration 
    //   if (Serial){
    //       Serial.println("LORA_RECEIVE");
    //   }
    //   state = SLEEP;

    //   break;
    // }

    case SLEEP:{
      // Enter low-power sleep mode 
      // 1. Set an alarm on the RTC to wake up after set duration
      // 2. Enter sleep mode 
      if (Serial){
          Serial.println("SLEEP");
      } 

      // rtc.setAlarm1(rtc.now() + TimeSpan(SLEEP_DURATION), DS3231_A1_Second); // Wake up after 60 seconds. May need to add back into code! Pretty sure this doesn't work tho.
      // rtc.now().unixtime() - initStartUnixTime_s < MEASUREMENT_WINDOW / 1000
      if (rtc.now().unixtime() - initStartUnixTime_s >= (SAMPLE_INTERVAL / 1000) - (LORA_TRANSMIT_INTERVAL / 1000)) { // Restart the sampling process after crossing the sample interval time threshold. Accounts for how long it takes to flush before getting your reading
        state = FLUSH_CHAMBER;
      }
      else {
        state = LORA_TRANSMIT; // Transmit again after waking up
        LowPower.sleep(LORA_TRANSMIT_INTERVAL); // Should this be deepSleep?
      }
      break;
    }

    case FAKE_SLEEP:{
      // Fake sleep for testing purposes
      if (stateStartMillis == 0) {
        stateStartMillis = millis();
        if (Serial){
          Serial.println("FAKE_SLEEP");
        } 
        // TODO: start flushing logic
      }
      else if (millis() - stateStartMillis >= FAKE_SLEEP_DURATION) { // Flush for 10 seconds
        state = ACCUMULATE_GAS;
        stateStartMillis = 0;
        state = INIT;
      }
      break;
    }

   

    case SERIAL_COMMANDS:{
      // Listen for serial commands. 
      // This is designed to be used with a list of commands to call important functions of the flux chamber for manual operation
      // Only necessary for easy testing, debugging, etc. Not needed for most people
      // Logic mostly written by Robin2 on https://forum.arduino.cc/t/simple-code-to-send-a-struct-between-arduinos-using-serial/672196 
      if (digitalRead(PIN_SWITCH) == HIGH) { // Wait for 5 seconds
        state = INIT; // return to normal operations 
        stateStartMillis = 0;
      }

      Serial.begin(9600);
      while(!Serial){
        // if (digitalRead(PIN_SWITCH) == HIGH) { 
        //   state = INIT; // return to normal operations 
        // }
        delay(100);
      }
      Serial.println("Ready for serial commands.");

      Command rxData;
      // while (digitalRead(PIN_SWITCH) == LOW){
      while (digitalRead(PIN_SWITCH) == LOW){
        if (recvStruct(&rxData)){
          // Process command based on rxData.id
          switch (rxData.id) {
            case 1:
              readDataBlocking();
              break;
            case 2:
              Serial.println("Received command to readSensorsOnce.");
              readDataBlocking();
              break;
            case 3:
              Serial.println("Received command to openVent.");
              openVent();
              break;
            case 4:
              Serial.println("Received command to closeVent.");
              closeVent();
              break;
            case 5:
              Serial.println("Received command to startFan.");
              digitalWrite(PIN_FAN, HIGH);
              break;
            case 6:
              Serial.println("Received command to stopFan.");
              digitalWrite(PIN_FAN, LOW);
              break;
            case 7:  
              Serial.println("Received command to setDateTime.");
              rtc.adjust(DateTime(rxData.year, rxData.month, rxData.day, rxData.hour, rxData.minute, rxData.second));
              Serial.println("DateTime SET:");
              Serial.print(rxData.year);
              Serial.print("-");
              Serial.print(rxData.month);
              Serial.print("-");
              Serial.println(rxData.day);
              Serial.print(rxData.hour);
              Serial.print(":");
              Serial.print(rxData.minute);  
              Serial.print(":");
              Serial.println(rxData.second);
              break;
            case 8:
              Serial.println("Received command to getDateTime.");
              char t[16];
              rtc_get_time(2, t, sizeof(t));
              Serial.print("Time:");
              Serial.println(t);
              break;
            case 9:
              Serial.println("Received command to transmitLoRa.");
              
              LoRaTransmitSingle();
            
              break;
            default:
              Serial.print("Unknown command ID: ");
              Serial.println(rxData.id);
              break;
          }
        }
        else if(flagReadContinuous && statePrev == READ_DATA) {
          state = READ_DATA;
          statePrev = SERIAL_COMMANDS;
        }
        else{
          delay(100);
        }
      }
      
      break;
    }
    case BLINK: {
      unsigned counter = 0;
      while (counter < 10){
        digitalWrite(LED_BUILTIN, HIGH);
        delay(500);
        digitalWrite(LED_BUILTIN, LOW);
        delay(100);
        counter++;
      }

      state = CALIBRATE; // Return to calibration mode after blinking
      break;
    }
    case CALIBRATE:{
      // Calibrate sensors. Print sensor readings to Serial for comparison with licor 
      if (!Serial){
          Serial.begin(9600);
          Serial.println("CALIBRATE");
      }

      if (digitalRead(PIN_SWITCH) == LOW){
        // state = CALIBRATE; // Stay in calibration mode
        delay(100);
        Serial.println("Switch is low");
        
        checkSerial();
        stateStartMillis = 0;
        statePrev = CALIBRATE;
        state = READ_DATA;
      } else {
        // state = INIT; // Move to logging mode
        delay(100);
        Serial.println("Switch is high");
        Serial.end();
        
        stateStartMillis = 0;
        state = INIT;
      }
      // delay(15000); //    Wait 15 seconds more, CO2 sensor already has 15 second delay
      // delay(5000); //    Wait 15 seconds more, CO2 sensor already has 15 second delay
      break;
    }
  case TEST_BLINK_DELAY: {
    Serial.println("TEST_BLINK_DELAY (blocking)");

    unsigned long start = millis();
    digitalWrite(LED_BUILTIN, HIGH);
    delay(5000); // Keep LED on for 5 seconds
    digitalWrite(LED_BUILTIN, LOW);

    Serial.println("TEST_BLINK_DELAY done");
    state = TEST_BLINK_DELAY;   // return where you want
    break;
    }
  
  case TEST_BLINK_MILLIS: {
    static bool initialized = false;
    static unsigned long start = 0;
    static unsigned long lastToggle = 0;
    static bool ledState = false;

    if (!initialized) {
        Serial.println("TEST_BLINK_MILLIS (non-blocking)");
        initialized = true;
        start = millis();
        lastToggle = millis();
        ledState = false;
        digitalWrite(LED_BUILTIN, LOW);
    }

  
    digitalWrite(LED_BUILTIN, HIGH);

    // End after 5 seconds
    if (millis() - start >= 5000) {
        digitalWrite(LED_BUILTIN, LOW);
        Serial.println("TEST_BLINK_MILLIS done");
        initialized = false;
        state = TEST_BLINK_MILLIS;   // return where you want
    }

    break;
    }

    case ERROR:{
      // Error handling code
      break;
    }
  }
}
