UBC-GSRC/2026-w2-kuhn-fluxchamber/firmware/test/test_main.cpp

#include <Arduino.h>
#include <unity.h>
#include "utils.h"
#include <Co2Meter_K33.h>
#include <stdio.h>

// Unity Assertions Cheat Sheet: https://github.com/ThrowTheSwitch/Unity/blob/master/docs/UnityAssertionsCheatSheetSuitableforPrintingandPossiblyFraming.pdf

void setUp() {}
void tearDown() {}

void test_led_builtin_pin_number() {
    TEST_ASSERT_EQUAL(6, LED_BUILTIN);
}

void test_sd_card_available() {
    SD_init();
    File dataFile = SD.open(logFilename, FILE_WRITE);
    TEST_ASSERT_TRUE_MESSAGE(dataFile, "SD card not available");
}

void test_data_logging() {
  // Clear the file first (optional)
  const char* testFile = "testFile.txt";

  if (!SD.exists(testFile)) {
        File file = SD.open(testFile, FILE_WRITE);
        if (file) {
            Serial.print("Created file: ");
            Serial.println(testFile);
            file.close();
        } else {
            Serial.print("Failed to create file: ");
            Serial.println(testFile);
        }
  }

  SensorData data;
  snprintf(data.date, sizeof(data.date), "2025/12/05");
  snprintf(data.time, sizeof(data.time), "12:00:00");
  snprintf(data.temp, sizeof(data.temp), "25.0");
  snprintf(data.rh, sizeof(data.rh), "50.0");
  snprintf(data.co2, sizeof(data.co2), "400.0");
  snprintf(data.ch4, sizeof(data.ch4), "0.2");
  log_data(data, testFile);

  // Read back file
  File dataFile = SD.open(testFile, FILE_READ);
  TEST_ASSERT_TRUE_MESSAGE(dataFile, "Failed to open testFile.txt for reading");

  // Read entire file into buffer
  String fileContent;
  while (dataFile.available()) {
      fileContent += (char)dataFile.read();
  }
  dataFile.close();

  // Extract last line (ignore trailing newline)
  int lastNewline = fileContent.lastIndexOf('\n');
  int prevNewline = fileContent.lastIndexOf('\n', lastNewline - 1);

  String lastLine;
  if (prevNewline >= 0) {
      lastLine = fileContent.substring(prevNewline + 1, lastNewline);
  } else {
      lastLine = fileContent.substring(0, lastNewline);
  }

  // Validate CSV output
  const char* expectedLine = "2025/12/05,12:00:00,400.0,25.0,50.0,0.2\r";
  TEST_ASSERT_EQUAL_STRING_MESSAGE(
      expectedLine,
      lastLine.c_str(),
      "CSV last line does not match expected output"
  );

  // Delete the test file
  bool deleted = SD.remove(testFile);
  TEST_ASSERT_TRUE_MESSAGE(deleted, "Failed to delete log file after test");
}

void test_SHT45_sensor()
{
  Adafruit_SHT4x sht4 = SHT45_init();
  sensors_event_t humidity, temp;
  sht4.getEvent(&humidity, &temp);
  TEST_ASSERT_FLOAT_WITHIN_MESSAGE(50.0, 50.0, humidity.relative_humidity, "Relative humidity not reaeding correctly."); // Example expected value
  TEST_ASSERT_FLOAT_WITHIN_MESSAGE(10.0, 25.0, temp.temperature, "Temperature not reading correctly."); // Example expected value
}

void test_K33_ELG_sensor(void)
{
  // Placeholder for K33 ELG sensor test
  Co2Meter_K33 k33;

  K33Reading data = k33.getReadings();

  TEST_ASSERT_TRUE(data.co2 >= 300.0);
  TEST_ASSERT_TRUE(data.temp >= -40.0 && data.temp <= 85.0);
  TEST_ASSERT_TRUE(data.rh >= 0.0 && data.rh <= 100.0);
}

void test_NGM2611_E13_sensor(void)
{
  MethaneSensor MethaneSensor(0);
  MethaneSensor.begin();
  
  float voltage = MethaneSensor.readVoltage();

  TEST_ASSERT_TRUE(voltage >= 0.0 && voltage <= 3.3);
}

void test_LoRa_communication(void)
{
  // Placeholder for LoRa communication test
  TEST_ASSERT_TRUE(true);
}

void test_low_power_mode(void)
{
  // Placeholder for low power mode test
  TEST_ASSERT_TRUE(true);
}

void test_RTC_connected(void){
  TEST_ASSERT_MESSAGE(rtc.begin(), "RTC not found.");
}

String formattedDate() {
    // __DATE__ --> "Dec  5 2025"
    const char* raw = __DATE__;
    char monthStr[4];
    int day, year;

    sscanf(raw, "%3s %d %d", monthStr, &day, &year);

    int month;
    if      (!strcmp(monthStr, "Jan")) month = 1;
    else if (!strcmp(monthStr, "Feb")) month = 2;
    else if (!strcmp(monthStr, "Mar")) month = 3;
    else if (!strcmp(monthStr, "Apr")) month = 4;
    else if (!strcmp(monthStr, "May")) month = 5;
    else if (!strcmp(monthStr, "Jun")) month = 6;
    else if (!strcmp(monthStr, "Jul")) month = 7;
    else if (!strcmp(monthStr, "Aug")) month = 8;
    else if (!strcmp(monthStr, "Sep")) month = 9;
    else if (!strcmp(monthStr, "Oct")) month = 10;
    else if (!strcmp(monthStr, "Nov")) month = 11;
    else if (!strcmp(monthStr, "Dec")) month = 12;
    else month = 13;

    char buffer[20];
    sprintf(buffer, "%04d/%02d/%02d", year, month, day);
    return String(buffer);
}

void test_RTC_date_synchronization(void)
{
    bool setTime = true;
    rtc_init(setTime);

    // Get RTC date into buffer
    char rtcDate[16];
    rtc_get_time(1, rtcDate, sizeof(rtcDate));  // mode 1 = date only

    char buffer[256];
    snprintf(buffer, sizeof(buffer), "RTC date: %s, Expected date: %s", rtcDate, formattedDate().c_str());
    TEST_MESSAGE(buffer);
    // Compare against expected formatted date
    
    TEST_ASSERT_EQUAL_STRING_MESSAGE(
        formattedDate().c_str(),
        rtcDate,
        "RTC date does not match expected formatted date"
    );

}


volatile bool irq = false;
void alarm_isr() { irq = true; }

void test_RTC_alarm(void)
{

  bool setTime = false;
  rtc_init(setTime);

  
  // Placeholder for RTC alarm function test
  // Making it so, that the alarm will trigger an interrupt
  pinMode(CLOCK_INTERRUPT_PIN, INPUT_PULLUP);
  attachInterrupt(digitalPinToInterrupt(CLOCK_INTERRUPT_PIN), alarm_isr, FALLING);
  Serial.println(digitalPinToInterrupt(CLOCK_INTERRUPT_PIN));

  TEST_ASSERT_TRUE_MESSAGE(
      digitalRead(CLOCK_INTERRUPT_PIN) == HIGH,
      "Interrupt pin not HIGH before test"
  );
  
  bool fired = rtc.alarmFired(1);
  TEST_ASSERT_TRUE_MESSAGE(!fired, "RTC fired before alarm was set");

  rtc.setAlarm1(
        rtc.now() + TimeSpan(3),
        DS3231_A1_Date // this mode triggers the alarm when the seconds match. See Doxygen for other options
  );

  while (rtc.alarmFired(1) == false) {
    delay(100);
  }
  bool fired2 = rtc.alarmFired(1);

  rtc.clearAlarm(1);
  detachInterrupt(digitalPinToInterrupt(CLOCK_INTERRUPT_PIN));

  TEST_ASSERT_TRUE_MESSAGE(fired2, "RTC alarm never fired");
  TEST_ASSERT_TRUE_MESSAGE(irq, "Interrupt never triggered");
}

void run_all_tests() {
    UNITY_BEGIN();
    RUN_TEST(test_led_builtin_pin_number);
    RUN_TEST(test_sd_card_available);
    // RUN_TEST(test_SHT45_sensor);
    RUN_TEST(test_data_logging);
    RUN_TEST(test_RTC_date_synchronization);
    RUN_TEST(test_RTC_alarm);
    RUN_TEST(test_K33_ELG_sensor);
    RUN_TEST(test_NGM2611_E13_sensor);
    UNITY_END();
}

void setup() {
    delay(2000);
    pinMode(LED_BUILTIN, OUTPUT);
    run_all_tests();
}

void loop() {
}
