UBC-GSRC/2026-w2-kuhn-fluxchamber/(commit log)

2026-01-05 Bill of Materials
    Added Bill of Materials to flux chamber repository
    [Bill Of Materials(Bill of Materials).csv]
2026-01-05 updated title
    Updated bill of materials to bill_of_materials for readability
    [Bill Of Materials(Bill of Materials).csv]
2026-01-07 Adding work in progress kicad schematic
    [data_logger.kicad_sch]
2026-01-07 Removing spaces in folder names
    [Bill Of Materials(Bill of Materials).csv]
2026-01-12 Adding datasheets and new schematic for methane sensor
    [data_logger.kicad_sch, ngm2611.kicad_pcb, ngm2611.kicad_sch]
2026-01-13 Adding voltage reading from methane sensor connected to ADS1115
2026-01-19 Adding lowside switch driver to main
2026-01-24 Adding serial command infrastructure to set the time while the physical switch on the controller is set to 'calibration' mode.
2026-01-24 Updating schematics as I resolder things to the prototype
    [data_logger.kicad_sch, ngm2611.kicad_sch]
2026-01-30 Adding INA228 chip to schematics and cleaning things up a bit
    [data_logger.kicad_sch]
2026-01-30 Adding reed switch input example. Just makes an led blink for now but will need to be low power wakeup
2026-02-07 Making more changes. Thinking of still using the connectors to deliver various power levels
    [data_logger.kicad_sch, logger_hat.kicad_pcb, logger_hat.kicad_sch]
2026-02-07 Read work log
    [logger_hat.kicad_pcb, logger_hat.kicad_sch]
2026-02-10 Changing delays to be non-blocking millis()
2026-04-23 Schematic changes to add motor driver and routed traces
    [data_logger.kicad_pcb, data_logger.kicad_sch, methane_sensor_carrier.kicad_pcb, methane_sensor_carrier.kicad_sch]
2026-04-28 Committing before testing new PCB V0.1
2026-04-30 Switching pins for direction
2026-05-01 Adding new serial commands list and changing flow diagram
2026-05-01 Adding comments for serial commands
    [bom.csv, complete_cycle_and_efficiency_dreams.csv, designators.csv, positions.csv]
2026-06-10 Updating the serial commands so that there is a terminal menu that allows you to control the functions of the chamber via microusb connection.
2026-06-17 Forgot to check if inputs were functional with external interrupts when I rearranged pins... Shouldve taken better notes!
    [data_logger.kicad_sch]
2026-07-16 Adding blinking for receiver when it gets a calibration message so we can use it as a reference when taking a manual measurement
2026-07-16 Adding a type value in the sensor data structure
2026-07-16 Accumulation and reading, adding type to sensor data, adding calibration before reading sequence, changing timing to match drawio.
2026-07-16 Sample interval to 2 hours and measurement window to 10 min
2026-10-21 Using battery voltage measurements from INA226 to better inform system
